openfnord/FT107m/IMG_20220121_160129.jpg

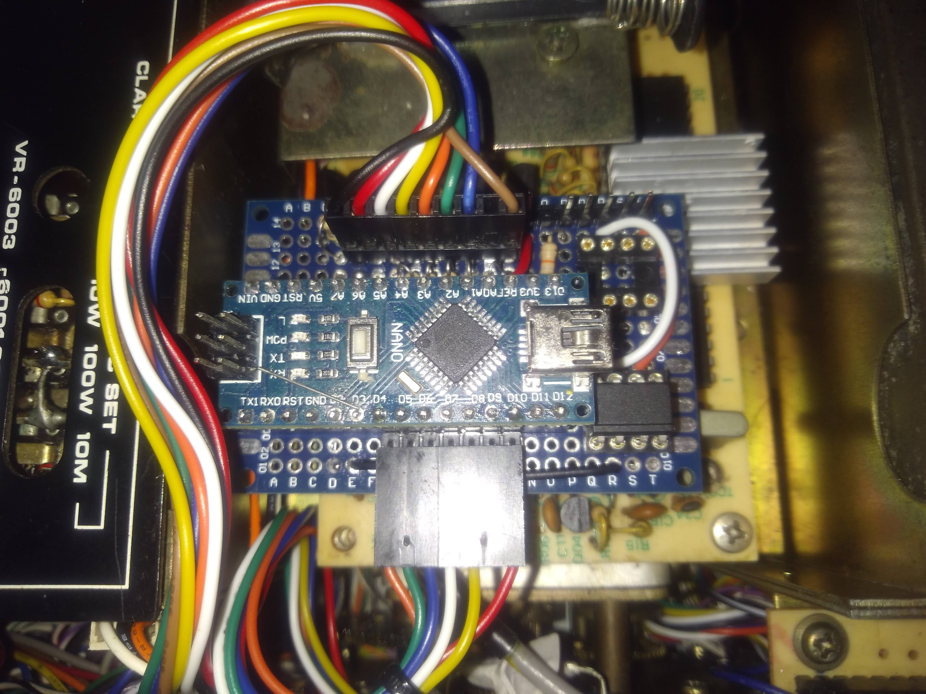
IMG_20220121_160129.jpg
