openfnord/FT107m/IMG_20220120_095338_2.jpg

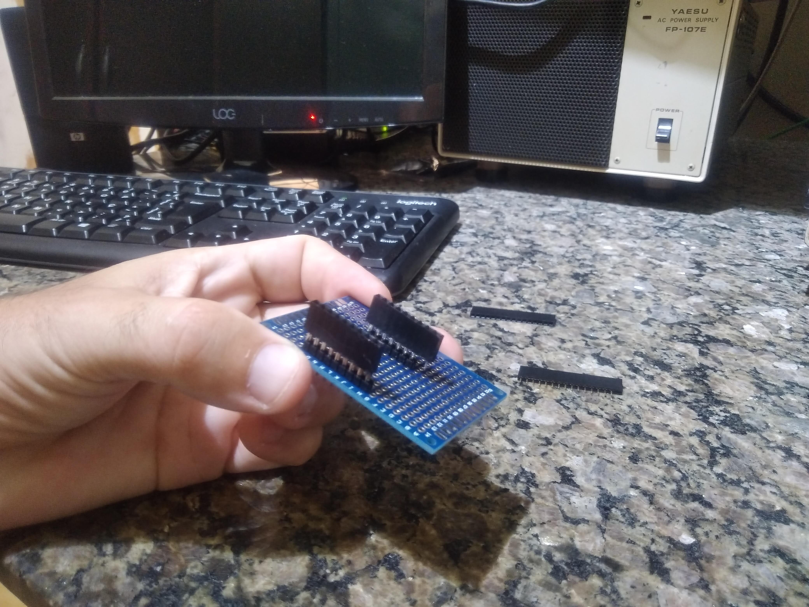
IMG_20220120_095338_2.jpg
