openfnord/FT107m/IMG_20220120_175831.jpg

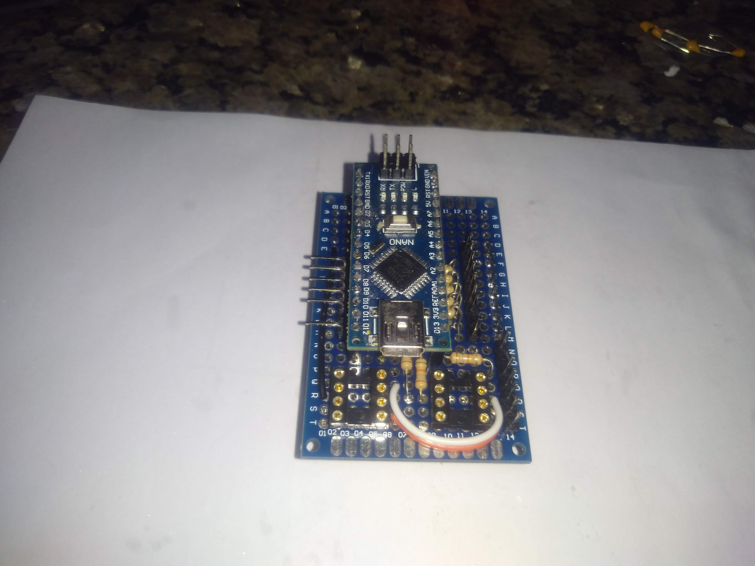
IMG_20220120_175831.jpg
