openfnord/FT107m/Schematic_ft107-v01_2022-03-28.png

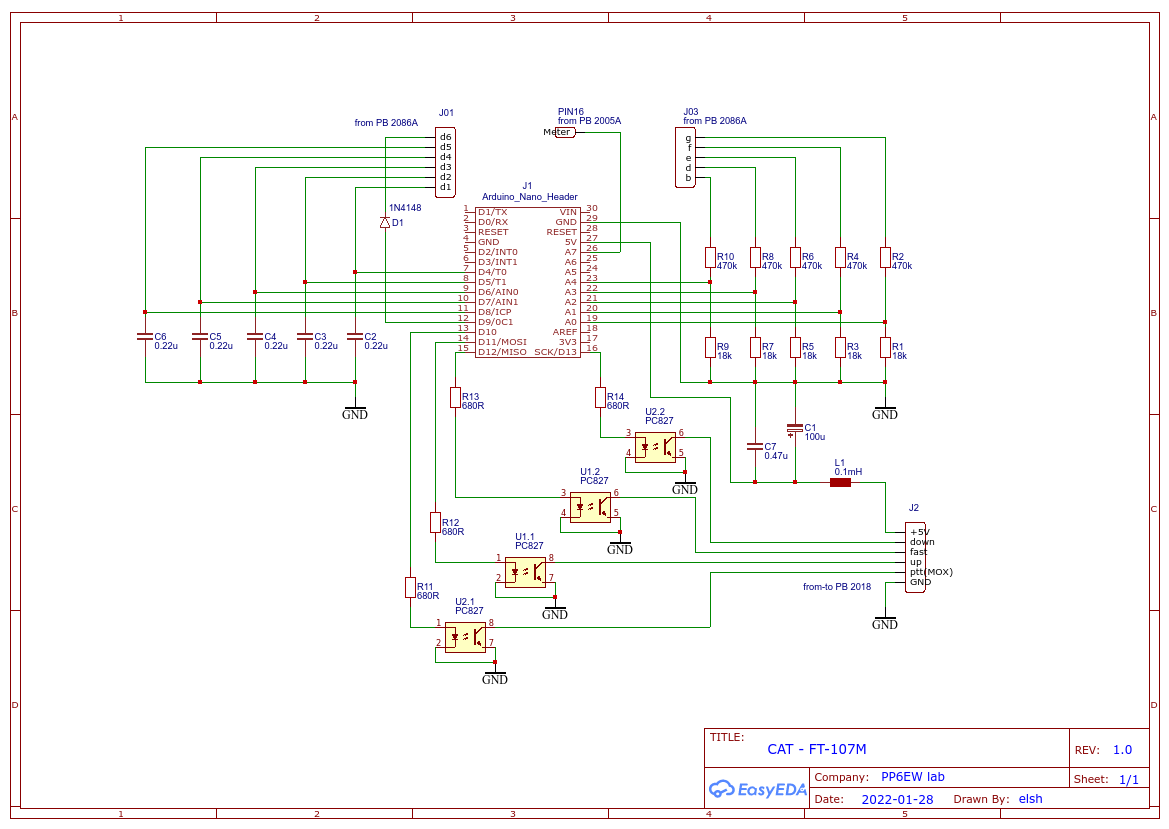
Schematic_ft107-v01_2022-03-28.png
