openfnord/FT107m/(commit log)

2022-01-31 Add files via upload
    Arduino circuit for yaesu FT-107M radio control by computer
2022-02-02 Add files via upload
    This code let us to test how good Arduino read the frequency after acquire signals from the counter unit pb 2086A.
